parkourlrc/pcb-yvolodym--18650-3v3-supply-90ec9281ad/Akku_3V3_Versorgung.kicad_pcb

## KiCad design Akku_3V3_Versorgung.kicad_pcb (2026-11-09)

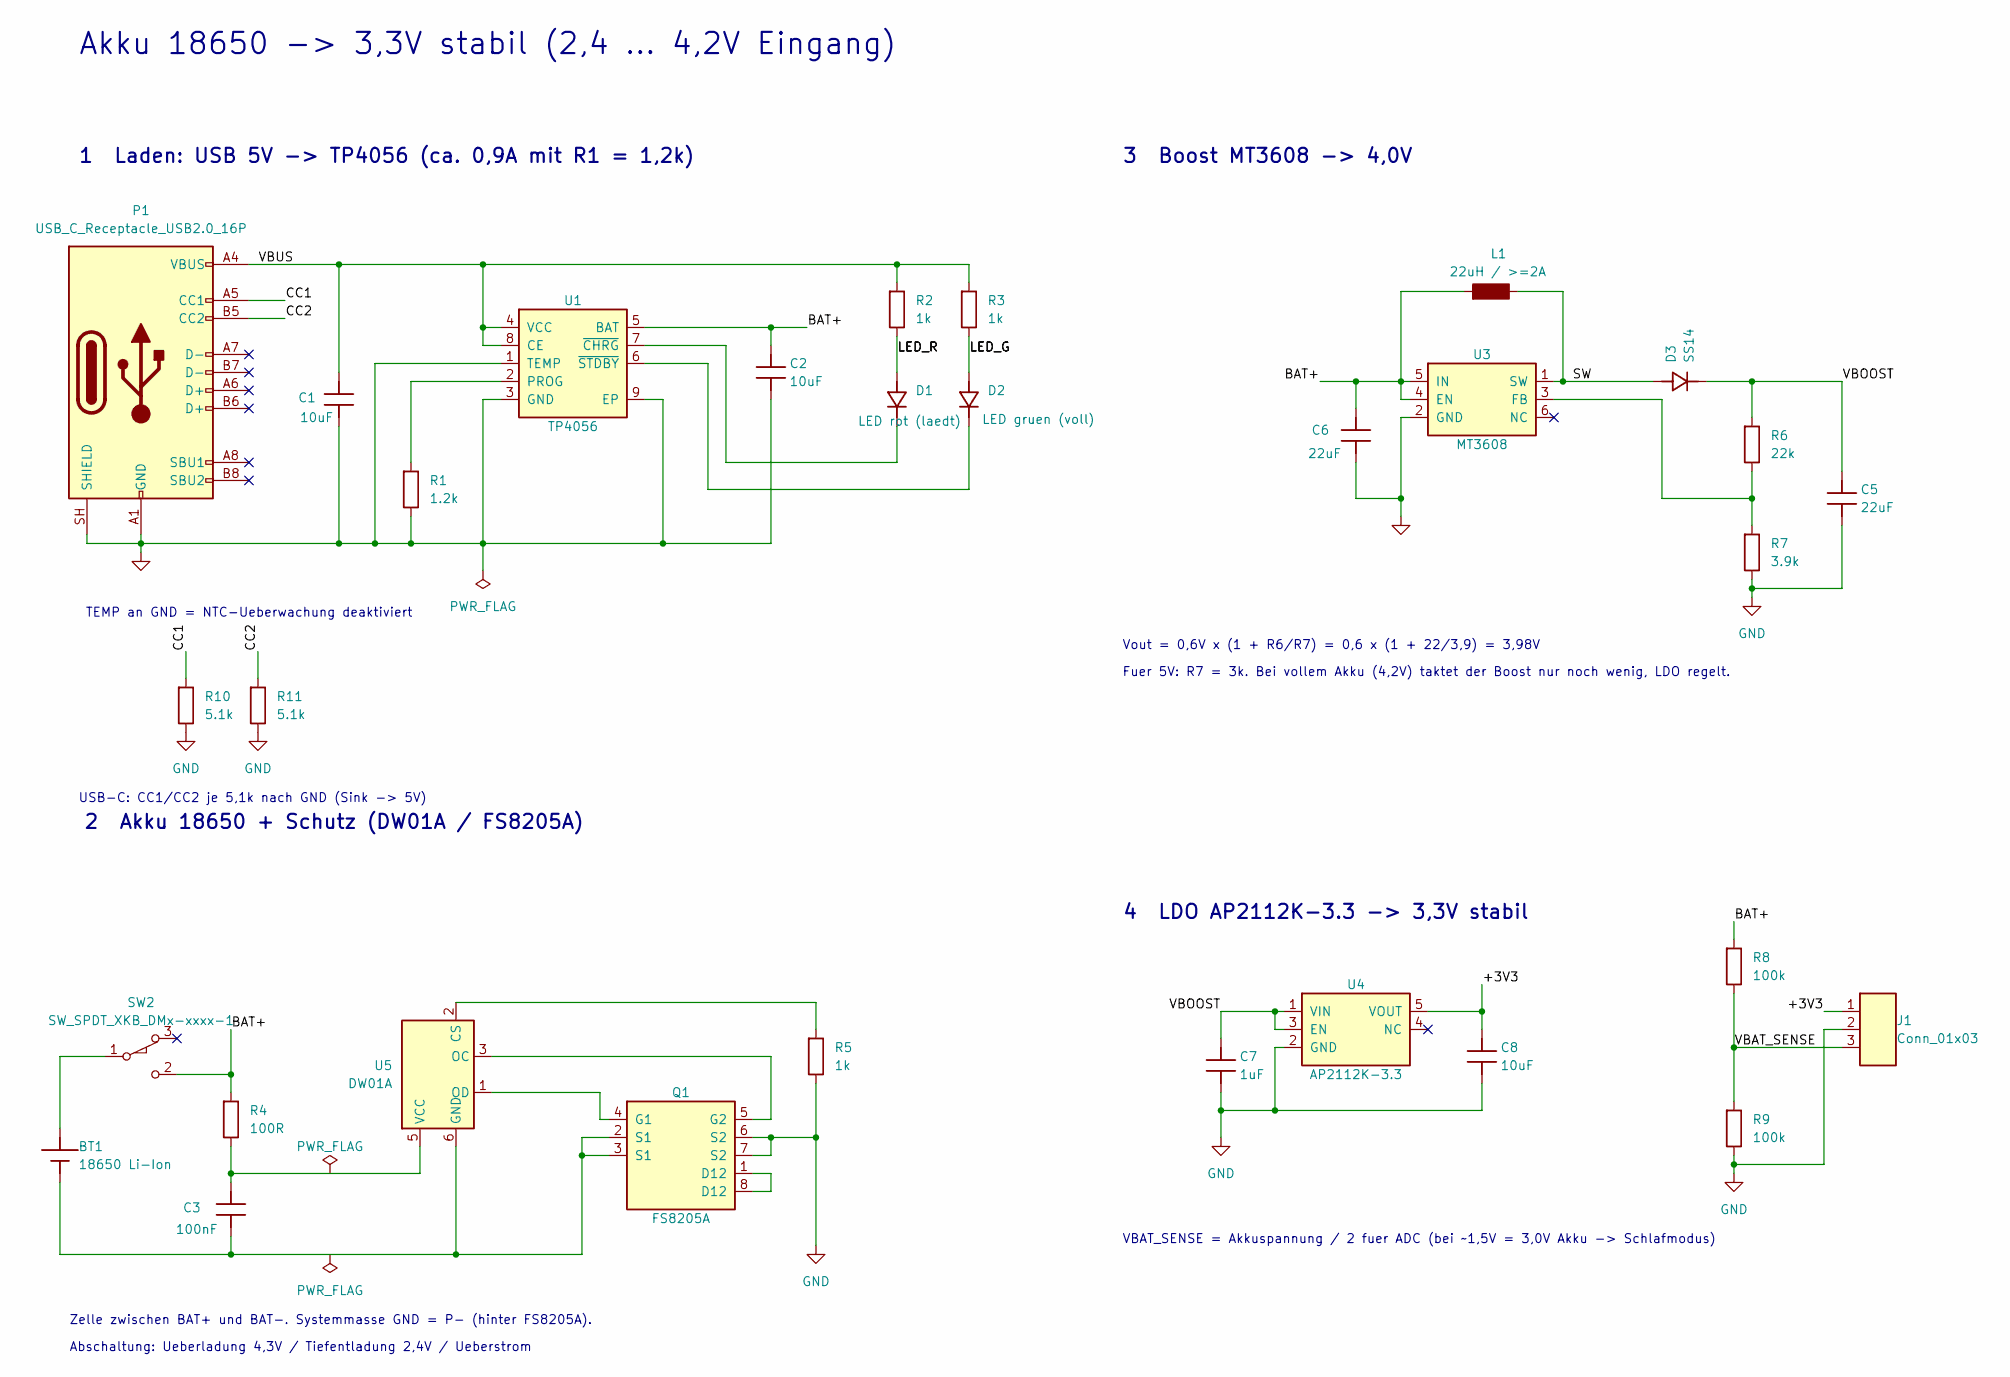
[picture p1: schematic Akku_3V3_Versorgung.kicad_sch, Akku 18650 -> 3,3V stabil]

Parts:
BT1: 18650 Li-Ion; NCR18650B
C1, C2, C8: 10uF; C_1206_3216Metric
C3: 100nF; C_1206_3216Metric
C5, C6: 22uF; C_1206_3216Metric
C7: 1uF; C_1206_3216Metric
D1: LED rot (laedt); LED_D2.0mm_W4.8mm_H2.5mm_FlatTop
D2: LED gruen (voll); LED_D2.0mm_W4.8mm_H2.5mm_FlatTop
D3: SS14; D_SMA
J1: Conn_01x03; JST_EH_B3B-EH-A_1x03_P2.50mm_Vertical
L1: 22uH / >=2A; L_1206_3216Metric
P1: USB_C_Receptacle_USB2.0_16P; USB_C_Receptacle_GCT_USB4105-xx-A_16P_TopMnt_Horizontal
Q1: FS8205A; TSSOP-8_4.4x3mm_P0.65mm
R1: 1.2k; R_1206_3216Metric
R2, R3, R5: 1k; R_1206_3216Metric
R4: 100R; R_1206_3216Metric
R6: 22k; R_1206_3216Metric
R7: 3.9k; R_1206_3216Metric
R8, R9: 100k; R_1206_3216Metric
R10, R11: 5.1k; R_1206_3216Metric
SW2: SW_SPDT_XKB_DMx-xxxx-1; Switch_Small
U1: TP4056; SOIC-8-1EP_3.9x4.9mm_P1.27mm_EP2.29x3mm
U3: MT3608; SOT-23-6
U4: AP2112K-3.3; SOT-23-5
U5: DW01A; SOT-23-6

Connections:
/+3V3: C8.1, J1.1, U4.5 (VOUT)
/BAT+: C2.1, C6.1, L1.1, R4.1, R8.1, SW2.2 (B), U1.5 (BAT), U3.4 (EN), U3.5 (IN)
/CC1: P1.A5 (CC1), R10.1
/CC2: P1.B5 (CC2), R11.1
/LED_G: D2.2 (A), R3.2
/LED_R: D1.2 (A), R2.2
/SW: D3.2 (A), L1.2, U3.1 (SW)
/VBAT_SENSE: J1.3, R8.2, R9.1
/VBOOST: C5.1, C7.1, D3.1 (K), R6.1, U4.1 (VIN), U4.3 (EN)
/VBUS: C1.1, P1.A4 (VBUS), P1.A9 (VBUS), P1.B4 (VBUS), P1.B9 (VBUS), R2.1, R3.1, U1.4 (VCC), U1.8 (CE)
GND: C1.2, C2.2, C5.2, C6.2, C7.2, C8.2, J1.2, P1.A1 (GND), P1.A12 (GND), P1.B1 (GND), P1.B12 (GND), P1.SH (SHIELD), Q1.6 (S2), Q1.7 (S2), R1.2, R5.2, R7.2, R9.2, R10.2, R11.2, U1.1 (TEMP), U1.3 (GND), U1.9 (EP), U3.2 (GND), U4.2 (GND)
unnamed: BT1.1 (+), SW2.1 (A)
unnamed: BT1.2 (-), C3.2, Q1.2 (S1), Q1.3 (S1), U5.6 (GND)
unnamed: D1.1 (K), U1.7 (~CHRG)
unnamed: D2.1 (K), U1.6 (~STDBY)
unnamed: Q1.1 (D12), Q1.8 (D12)
unnamed: Q1.4 (G1), U5.1 (OD)
unnamed: Q1.5 (G2), U5.3 (OC)
unnamed: R1.1, U1.2 (PROG)
unnamed: R6.2, R7.1, U3.3 (FB)
unnamed: R5.1, U5.2 (CS)
unnamed: C3.1, R4.2, U5.5 (VCC)

Notes on the sheet:
1 Laden: USB 5V -> TP4056 (ca. 0,9A mit R1 = 1,2k)
Akku 18650 -> 3,3V stabil (2,4 ... 4,2V Eingang)
VBAT_SENSE = Akkuspannung / 2 fuer ADC (bei ~1,5V = 3,0V Akku -> Schlafmodus)
Fuer 5V: R7 = 3k. Bei vollem Akku (4,2V) taktet der Boost nur noch wenig, LDO regelt.
3 Boost MT3608 -> 4,0V
Vout = 0,6V x (1 + R6/R7) = 0,6 x (1 + 22/3,9) = 3,98V
Abschaltung: Ueberladung 4,3V / Tiefentladung 2,4V / Ueberstrom
4 LDO AP2112K-3.3 -> 3,3V stabil
Zelle zwischen BAT+ und BAT-. Systemmasse GND = P- (hinter FS8205A).
USB-C: CC1/CC2 je 5,1k nach GND (Sink -> 5V)
2 Akku 18650 + Schutz (DW01A / FS8205A)
TEMP an GND = NTC-Ueberwachung deaktiviert

Board: 2 copper layers, 31 parts (6 on the bottom side), 22 nets, no tracks yet.
