parkourlrc/pcb-yvolodym--18650-3v3-supply-90ec9281ad/(commit log)

2026-11-07 Platine: verwaisten Footprint U2 entfernt
    - U2 (DW01A) war ein Überbleibsel aus der Zeit vor der Umstellung auf das
    Standardsymbol U5 und hatte keine Verknüpfung zum Schaltplan
    - Schaltplan und Platine jetzt deckungsgleich (32 Bauteile, DRC-Parität 0 Fehler)
    - Projekteinstellungen von KiCad aktualisiert
    [Akku_3V3_Versorgung.kicad_pcb]
2026-11-08 Platine: DRC-Fehler behoben (Bahnbreite, Randabstand, USB-C-Lochabstand)
    - 21 Leiterbahnstücke von 0,15 mm auf 0,2 mm verbreitert
    - /CC2 auf B.Cu vom oberen Platinenrand weg verlegt (y 42,06 -> 42,3)
    - Neue Regeldatei Akku_3V3_Versorgung.kicad_dru: 0,15 mm Lochabstand
    innerhalb des USB-C-Footprints P1 (bauartbedingt beim GCT USB4105)
    - Zonen neu gefüllt
    DRC: 31 -> 2 Verstöße (verbleibend: Wärmefallen U3 Pad 2, J1 Pad 2)
    [Akku_3V3_Versorgung.kicad_pcb]
2026-11-09 C4 entfernt, Doku auf Ist-Zustand gebracht
    - Schaltplan: C4 (22 µF an BAT+) entfernt, C6 bleibt als Eingangskondensator des MT3608
    - Platine: C4 entfernt, Leiterbahnen und Vias entfernt (Bauteile platziert, nicht geroutet)
    - README/CLAUDE.md: Stückliste, SW2, Dateiliste und Status auf Ist-Zustand
    - voltage-measurements.md: Sollwerte nach TP4056-Datenblatt (0,9 A, 90 mA, 140 °C)
    [Akku_3V3_Versorgung.kicad_pcb, Akku_3V3_Versorgung.kicad_sch]
